Misaka0x2730/blackmagic-hardware/contrib/railgun/BMP2_Railgun.pdf

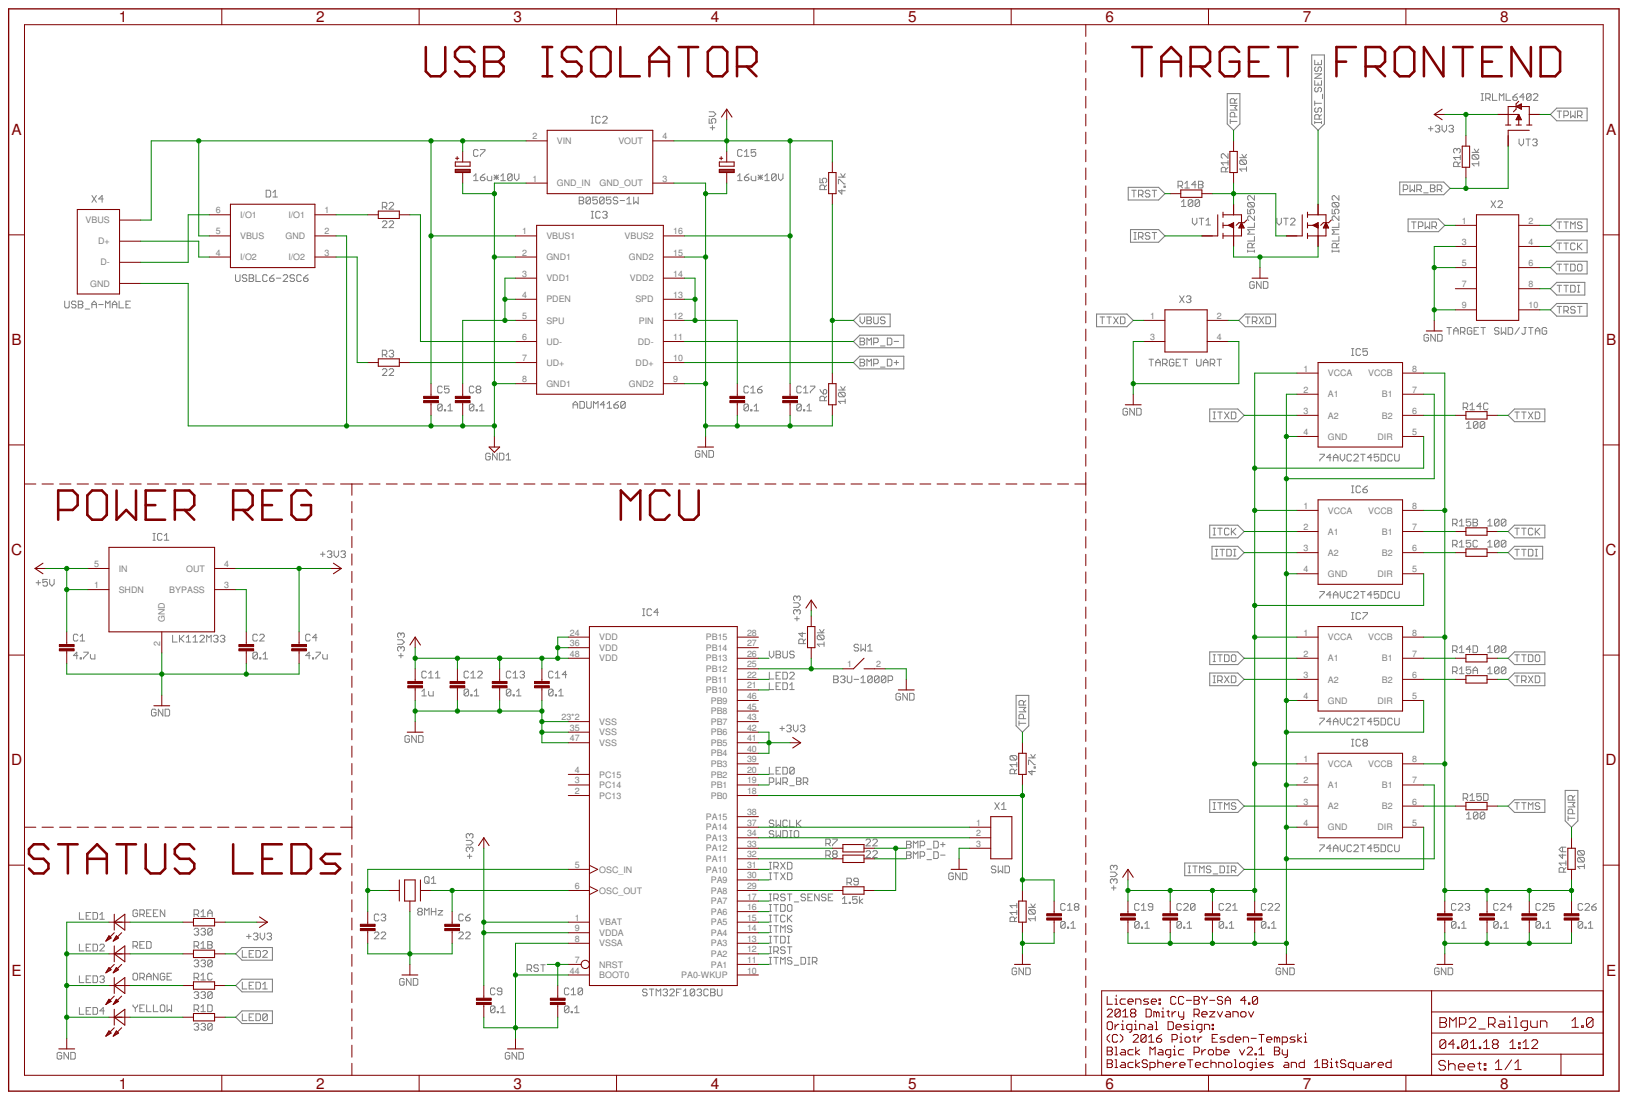
[picture p1: page 1]
