Misaka0x2730/blackmagic-hardware/contrib/railgun/BMP2_Railgun.brd

## EAGLE design contrib/railgun/BMP2_Railgun.brd (2018-02-01)

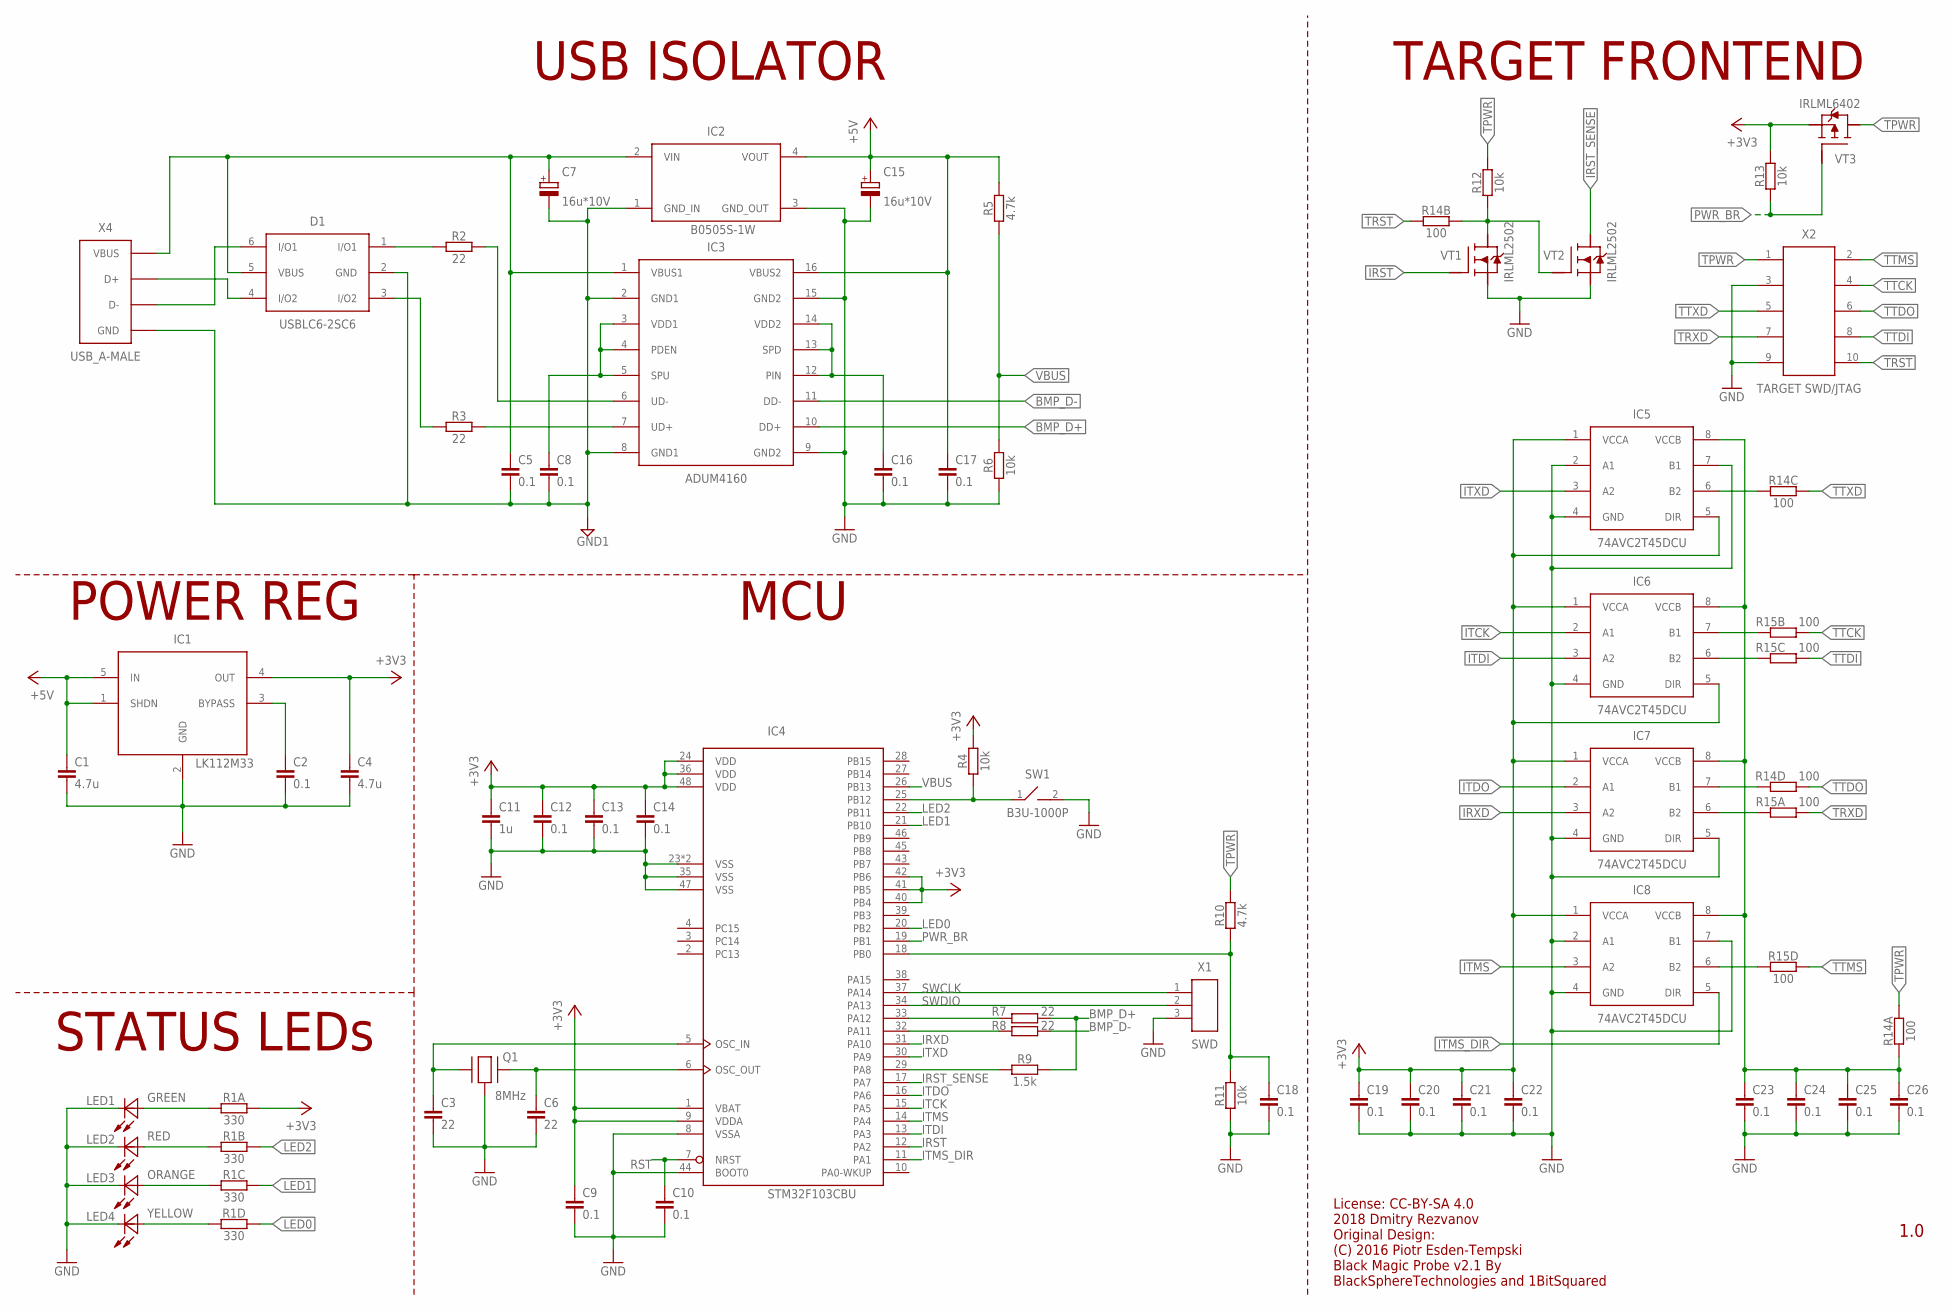
[picture p2: schematic BMP2_Railgun.sch]

Parts:
C1, C4: 4.7u; 0603
C2, C8, C9, C10, C12, C13, C14, C16, C18, C19, C20, C21, C22, C23, C24, C25, C26: 0.1; 0402
C3, C6: 22; 0402
C5, C17: 0.1; 0603
C7, C15: 16u*10V; C3216/A
C11: 1u; 0603
D1: USBLC6-2SC6; SOT23-6L
IC1: LK112M33; SOT23-5L
IC2: B0505S-1W; 4SIP
IC3: ADUM4160; SO-16W
IC4: STM32F103CBU; UFQFPN48
IC5, IC6, IC7, IC8: 74AVC2T45DCU; S-PDSO-G8
LED1: GREEN; LED0603
LED2: RED; LED0603
LED3: ORANGE; LED0603
LED4: YELLOW; LED0603
Q1: 8MHz; 3225
R1: 330; ARRAY_0603
R2, R3, R7, R8: 22; 0402
R4, R6, R11, R12, R13: 10k; 0402
R5, R10: 4.7k; 0402
R9: 1.5k; 0402
R14, R15: 100; ARRAY_0603
SW1: B3U-1000P
VT1, VT2: IRLML2502; SOT23
VT3: IRLML6402; SOT23
X1: SWD; PH1X03_1.27
X2: TARGET SWD/JTAG; IDC-10(FACE)
X4: USB_A-MALE; USB-A-MALE

Connections:
+3V3: C4.1, C9.1, C11.1, C12.1, C13.1, C14.1, C19.1, C20.1, C21.1, C22.1, IC1.4 (OUT), IC4.1 (VBAT), IC4.9 (VDDA), IC4.24 (VDD), IC4.36 (VDD), IC4.40 (PB4), IC4.41 (PB5), IC4.42 (PB6), IC4.48 (VDD), IC5.1 (VCCA), IC5.5 (DIR), IC6.1 (VCCA), IC6.5 (DIR), IC7.1 (VCCA), IC8.1 (VCCA), R1.1, R4.1, R13.1, VT3.2 (S)
+5V: C1.1, C15.2 (+), C17.1, IC1.1 (SHDN), IC1.5 (IN), IC2.4 (VOUT), IC3.16 (VBUS2), R5.1
BMP_D+: IC3.10 (DD+), R7.1, R9.1
BMP_D-: IC3.11 (DD-), R8.1
GND: C1.2, C2.2, C3.2, C4.2, C6.2, C9.2, C10.2, C11.2, C12.2, C13.2, C14.2, C15.1 (-), C16.2, C17.2, C18.2, C19.2, C20.2, C21.2, C22.2, C23.2, C24.2, C25.2, C26.2, IC1.2 (GND), IC2.3 (GND_OUT), IC3.9 (GND2), IC3.15 (GND2), IC4.8 (VSSA), IC4.23 (VSS), IC4.35 (VSS), IC4.44 (BOOT0), IC4.47 (VSS), IC4.49 (VSS), IC5.2 (A1), IC5.4 (GND), IC5.7 (B1), IC6.4 (GND), IC7.4 (GND), IC7.5 (DIR), IC8.2 (A1), IC8.4 (GND), IC8.7 (B1), LED1.2 (C), LED2.2 (C), LED3.2 (C), LED4.2 (C), Q1.2 (GND), Q1.4 (GND), R6.2, R11.2, SW1.2, VT1.2 (S), VT2.2 (S), X1.3, X2.3, X2.9
GND1: C5.2, C7.1 (-), C8.2, D1.2 (GND), IC2.1 (GND_IN), IC3.2 (GND1), IC3.8 (GND1), X4.1 (GND), X4.GND@1 (GND), X4.GND@2 (GND)
IRST: IC4.12 (PA2), VT1.1 (G)
IRST_SENSE: IC4.17 (PA7), VT2.3 (D)
IRXD: IC4.31 (PA10), IC7.3 (A2)
ITCK: IC4.15 (PA5), IC6.2 (A1)
ITDI: IC4.13 (PA3), IC6.3 (A2)
ITDO: IC4.16 (PA6), IC7.2 (A1)
ITMS: IC4.14 (PA4), IC8.3 (A2)
ITMS_DIR: IC4.11 (PA1), IC8.5 (DIR)
ITXD: IC4.30 (PA9), IC5.3 (A2)
LED0: IC4.20 (PB2), R1.4 (1)
LED1: IC4.21 (PB10), R1.3 (1)
LED2: IC4.22 (PB11), R1.2 (1)
unnamed: D1.1 (I/O1), R2.1
unnamed: IC3.7 (UD+), R3.2
unnamed: D1.3 (I/O2), R3.1
unnamed: IC3.6 (UD-), R2.2
unnamed: IC4.32 (PA11), R8.2
unnamed: IC4.33 (PA12), R7.2
unnamed: C8.1, IC3.3 (VDD1), IC3.4 (PDEN), IC3.5 (SPU)
unnamed: D1.6 (I/O1), X4.3 (D-)
unnamed: IC4.25 (PB12), R4.2, SW1.1
unnamed: D1.4 (I/O2), X4.2 (D+)
unnamed: C16.1, IC3.12 (PIN), IC3.13 (SPD), IC3.14 (VDD2)
unnamed: C6.1, IC4.6 (OSC_OUT), Q1.3 (2)
unnamed: C3.1, IC4.5 (OSC_IN), Q1.1
unnamed: LED1.1 (A), R1.8 (2)
unnamed: C5.1, C7.2 (+), D1.5 (VBUS), IC2.2 (VIN), IC3.1 (VBUS1), X4.4 (VBUS)
unnamed: LED4.1 (A), R1.5 (2)
unnamed: LED3.1 (A), R1.6 (2)
unnamed: LED2.1 (A), R1.7 (2)
unnamed: C2.1, IC1.3 (BYPASS)
unnamed: R12.1, R14.2 (1), VT1.3 (D), VT2.1 (G)
unnamed: IC4.29 (PA8), R9.2
unnamed: C18.1, IC4.18 (PB0), R10.2, R11.1
PWR_BR: IC4.19 (PB1), R13.2, VT3.1 (G)
RST: C10.1, IC4.7 (NRST)
SWCLK: IC4.37 (PA14), X1.1
SWDIO: IC4.34 (PA13), X1.2
TPWR: R10.1, R12.2, R14.8 (2), VT3.3 (D), X2.1
TRST: R14.7 (2), X2.10
TRXD: R15.8 (2), X2.7
TTCK: R15.7 (2), X2.4
TTDI: R15.6 (2), X2.8
TTDO: R14.5 (2), X2.6
TTMS: R15.5 (2), X2.2
TTXD: R14.6 (2), X2.5
VBUS: IC4.26 (PB13), R5.2, R6.1
XRXD: IC7.6 (B2), R15.1
XTCK: IC6.7 (B1), R15.2 (1)
XTDI: IC6.6 (B2), R15.3 (1)
XTDO: IC7.7 (B1), R14.4 (1)
XTMS: IC8.6 (B2), R15.4 (1)
XTPWR: C23.1, C24.1, C25.1, C26.1, IC5.8 (VCCB), IC6.8 (VCCB), IC7.8 (VCCB), IC8.8 (VCCB), R14.1
XTXD: IC5.6 (B2), R14.3 (1)

Notes on the sheet:
USB ISOLATOR
POWER REG
STATUS LEDs
TARGET FRONTEND
MCU
License: CC-BY-SA 4.0 2018 Dmitry Rezvanov Original Design: (C) 2016 Piotr Esden-Tempski Black Magic Probe v2.1 By BlackSphereTechnologies and 1BitSquared
1.0

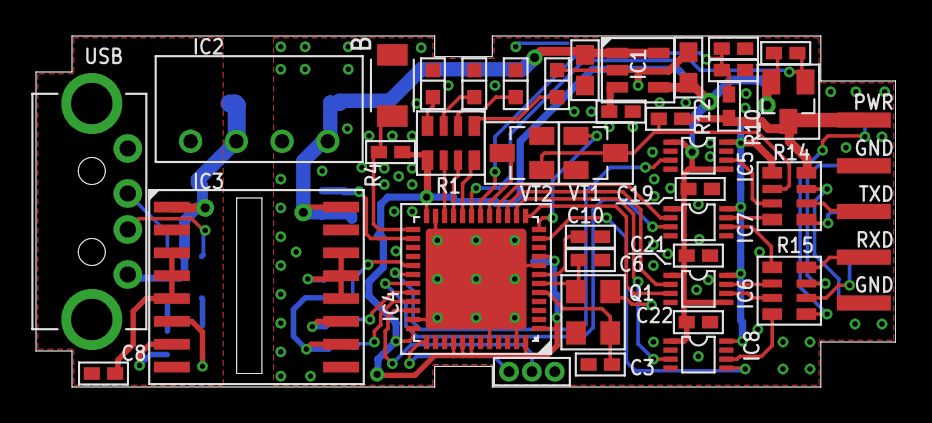
[picture p3: board BMP2_Railgun.brd from above]

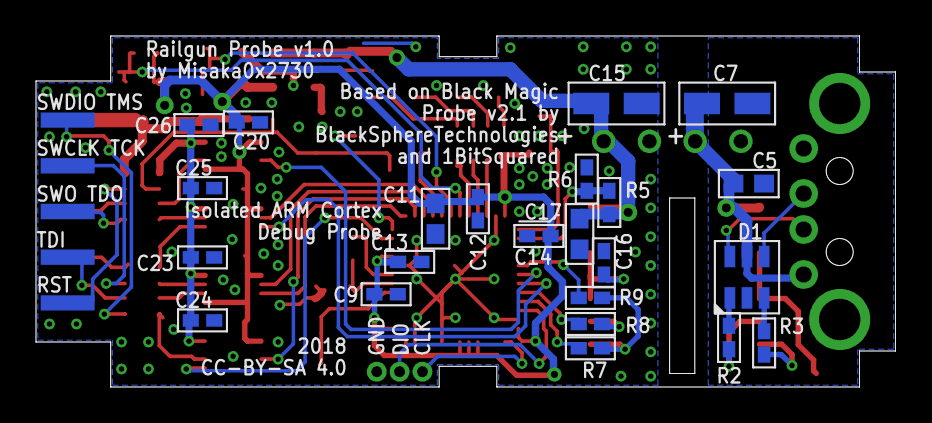
[picture p4: board BMP2_Railgun.brd from below]

Board: 2 copper layers, 47.8 x 19.5 mm, 62 parts (23 on the bottom side), 60 nets.
