Misaka0x2730/blackmagic-hardware/(commit log)

2018-01-02 Fixed errors in angle of line.
    [BMP2_Railgun.brd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]
2018-01-03 Fixed bug with single node in the net XRST.
    [BMP2_Railgun.brd, BMP2_Railgun.sch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]
2018-01-05 Fixed error in position of USB connector.
    [BMP2_Railgun.brd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]
2018-01-05 Fixed board outline..
    [BMP2_Railgun.brd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]
2018-01-19 Fixed board size.
    [BMP2_Railgun.brd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]
